ChrisEsau/GDRIVE_Hardware/MotorDriverXL/ComponentReview.ods

Reference | Value | Footprint | MPN | Datasheet
C1 | CAP_2.2uF_25V_0603 | Capacitor_SMD:C_0603_1608Metric | GRM188R61E225KA12D
C10 | CAP_2.2uF_25V_0603 | Capacitor_SMD:C_0603_1608Metric | GRM188R61E225KA12D
C11 | CAP_2.2uF_25V_0603 | Capacitor_SMD:C_0603_1608Metric | GRM188R61E225KA12D
C12 | CAP_2.2uF_25V_0603 | Capacitor_SMD:C_0603_1608Metric | GRM188R61E225KA12D
C13 | CAP_0.022uF_100V_0603 | Capacitor_SMD:C_0603_1608Metric | C0603C223K1RACTU
C14 | CAP_15nF_50V_0603 | Capacitor_SMD:C_0603_1608Metric | CC0603JRX7R9BB153
C15 | CAP_4.7uF_100V_1210 | Capacitor_SMD:C_1210_3225Metric | GCM32DC72A475KE02L
C16 | CAP_2.2uF_25V_0603 | Capacitor_SMD:C_0603_1608Metric | GRM188R61E225KA12D
C17 | CAP_100nF_50V_0603 | Capacitor_SMD:C_0603_1608Metric | CC0603MRY5V9BB104
C18 | CAPP_100uF_6.3V_TANT | Capacitor_SMD:C_1210_3225Metric | 581-TPSB107K006R0400 | https://www.mouser.com/datasheet/2/40/tps-776850.pdf
C19 | CAP_100nF_50V_0603 | Capacitor_SMD:C_0603_1608Metric | CC0603MRY5V9BB104
C2 | CAP_2.2uF_25V_0603 | Capacitor_SMD:C_0603_1608Metric | GRM188R61E225KA12D
C20 | CAP_100nF_50V_0603 | Capacitor_SMD:C_0603_1608Metric | CC0603MRY5V9BB104
C21 | CAP_100nF_50V_0603 | Capacitor_SMD:C_0603_1608Metric | CC0603MRY5V9BB104
C22 | CAP_4.7uF_100V_1210 | Capacitor_SMD:C_1210_3225Metric | GCM32DC72A475KE02L
C23 | CAP_2.2uF_25V_0603 | Capacitor_SMD:C_0603_1608Metric | GRM188R61E225KA12D
C24 | CAPP_100uF_6.3V_TANT | Capacitor_SMD:C_1210_3225Metric | 581-TPSB107K006R0400 | https://www.mouser.com/datasheet/2/40/tps-776850.pdf
C25 | CAP_4.7uF_100V_1210 | Capacitor_SMD:C_1210_3225Metric | GCM32DC72A475KE02L
C26 | CAP_4.7uF_100V_1210 | Capacitor_SMD:C_1210_3225Metric | GCM32DC72A475KE02L
C27 | CAP_4.7uF_100V_1210 | Capacitor_SMD:C_1210_3225Metric | GCM32DC72A475KE02L
C28 | CAP_4.7uF_100V_1210 | Capacitor_SMD:C_1210_3225Metric | GCM32DC72A475KE02L
C29 | CAP_4.7uF_100V_1210 | Capacitor_SMD:C_1210_3225Metric | GCM32DC72A475KE02L
C3 | CAP_2.2uF_25V_0603 | Capacitor_SMD:C_0603_1608Metric | GRM188R61E225KA12D
C30 | CAP_4.7uF_100V_1210 | Capacitor_SMD:C_1210_3225Metric | GCM32DC72A475KE02L
C31 | CAPP_220uF_63V_10X15_THT | Capacitor_THT:CP_Radial_D10.0mm_P5.00mm | ESK227M063AH2AA
C32 | CAP_15pF_16V_0603 | Capacitor_SMD:C_0603_1608Metric | VJ0603A150KXJPW1BC
C33 | CAPP_220uF_63V_10X15_THT | Capacitor_THT:CP_Radial_D10.0mm_P5.00mm | ESK227M063AH2AA
C34 | CAP_15pF_16V_0603 | Capacitor_SMD:C_0603_1608Metric | VJ0603A150KXJPW1BC
C35 | CAP_2.2uF_25V_0603 | Capacitor_SMD:C_0603_1608Metric | GRM188R61E225KA12D
C36 | CAP_100nF_50V_0603 | Capacitor_SMD:C_0603_1608Metric | CC0603MRY5V9BB104
C37 | CAP_2.2uF_25V_0603 | Capacitor_SMD:C_0603_1608Metric | GRM188R61E225KA12D
C38 | CAP_2.2uF_25V_0603 | Capacitor_SMD:C_0603_1608Metric | GRM188R61E225KA12D
C39 | CAP_2.2uF_25V_0603 | Capacitor_SMD:C_0603_1608Metric | GRM188R61E225KA12D
C4 | CAP_2.2uF_25V_0603 | Capacitor_SMD:C_0603_1608Metric | GRM188R61E225KA12D
C40 | CAP_2.2nF_50V_0603 | Capacitor_SMD:C_0603_1608Metric | C0603C222J5RACTU
C41 | CAP_2.2nF_50V_0603 | Capacitor_SMD:C_0603_1608Metric | C0603C222J5RACTU
C42 | CAP_2.2uF_25V_0603 | Capacitor_SMD:C_0603_1608Metric | GRM188R61E225KA12D
C5 | CAP_2.2uF_25V_0603 | Capacitor_SMD:C_0603_1608Metric | GRM188R61E225KA12D
C6 | CAP_2.2uF_25V_0603 | Capacitor_SMD:C_0603_1608Metric | GRM188R61E225KA12D
C7 | CAP_6.8nF_10V_0603 | Capacitor_SMD:C_0603_1608Metric | VJ0603Y682MXQPW1BC
C8 | CAP_120pF_50V_0603 | Capacitor_SMD:C_0603_1608Metric | VJ0603A121JXAAC
C9 | CAP_2.2uF_25V_0603 | Capacitor_SMD:C_0603_1608Metric | GRM188R61E225KA12D
D1 | D_60V_2A_PMEG6020ER | Diode_SMD:D_SOD-123F | PMEG6020ER | https://www.mouser.com/datasheet/2/916/PMEG6020ER-1371207.pdf
D2 | D_TVS_5V | digikey-footprints:DO-214AC |  | https://www.mouser.com/datasheet/2/240/Littelfuse_TVS_Diode_SMAJ_Datasheet.pdf-540740.pdf
D3 | LED_GREEN | LED_SMD:LED_0603_1608Metric | LTST-C191KGKT
D4 | LED_RED | LED_SMD:LED_0603_1608Metric | LTST-C191KRKT
D5 | LED_BLUE | LED_SMD:LED_0603_1608Metric | LTST-C191TBKT
J1 | CONN_USB_B_Micro | digikey-footprints:USB_Micro_B_Female_10118193-0001LF | 10118193-0001LF | https://www.mouser.com/ProductDetail/Amphenol-FCI/10118193-0001LF
L1 | L_2.2uH_600mA_MLZ2012N2R2L | Inductor_SMD:L_0805_2012Metric | MLZ2012N2R2L
L2 | L_22uH_1.5A_SDR0805 | footprints:L_BOURNS_SDR0805 | 652-SDR0805-220ML
P1 | CONN_CAN | Connector_PinHeader_2.54mm:PinHeader_1x04_P2.54mm_Vertical | 90136-1104 | https://www.mouser.com/datasheet/2/276/0901361104_PCB_HEADERS-176953.pdf
P2 | CONN_HALL | Connector_PinHeader_2.54mm:PinHeader_1x05_P2.54mm_Vertical | 90136-1305 | https://www.mouser.com/datasheet/2/276/0901361305_PCB_HEADERS-176832.pdf
P3 | CONN_COMM | Connector_PinHeader_2.54mm:PinHeader_1x08_P2.54mm_Vertical | 90136-1108 | https://www.mouser.com/datasheet/2/276/0901361108_PCB_HEADERS-151719.pdfhttps://www.mouser.com/datasheet/2/276/0901361305_PCB_HEADERS-176832.pdf
P4 | CONN_SWD | Connector_PinHeader_2.54mm:PinHeader_1x05_P2.54mm_Vertical | 90136-1305 | https://www.mouser.com/datasheet/2/276/0901361305_PCB_HEADERS-176832.pdf
P5 | PAD_4x5 | footprints:PAD_4x5
P6 | PAD_4x5 | footprints:PAD_4x5
P7 | PAD_4x5 | footprints:PAD_4x5
P8 | PAD_4x5 | footprints:PAD_4x5
P9 | PAD_4x5 | footprints:PAD_4x5
Q1 | Q_NMOS_60V_70A | footprints:POWERPAK SO-8L SINGLE | SQJA04EP-T1_GE3 | https://www.mouser.com/datasheet/2/427/sqja04ep-1110899.pdfhttps://www.mouser.com/datasheet/2/196/irf7749l2pbf-1302913.pdf
Q2 | Q_NMOS_60V_70A | footprints:POWERPAK SO-8L SINGLE | SQJA04EP-T1_GE3 | https://www.mouser.com/datasheet/2/427/sqja04ep-1110899.pdfhttps://www.mouser.com/datasheet/2/196/irf7749l2pbf-1302913.pdf
Q3 | Q_NMOS_60V_70A | footprints:POWERPAK SO-8L SINGLE | SQJA04EP-T1_GE3 | https://www.mouser.com/datasheet/2/427/sqja04ep-1110899.pdfhttps://www.mouser.com/datasheet/2/196/irf7749l2pbf-1302913.pdf
Q4 | Q_NMOS_60V_70A | footprints:POWERPAK SO-8L SINGLE | SQJA04EP-T1_GE3 | https://www.mouser.com/datasheet/2/427/sqja04ep-1110899.pdfhttps://www.mouser.com/datasheet/2/196/irf7749l2pbf-1302913.pdf
Q5 | Q_NMOS_60V_70A | footprints:POWERPAK SO-8L SINGLE | SQJA04EP-T1_GE3 | https://www.mouser.com/datasheet/2/427/sqja04ep-1110899.pdfhttps://www.mouser.com/datasheet/2/196/irf7749l2pbf-1302913.pdf
Q6 | Q_NMOS_60V_70A | footprints:POWERPAK SO-8L SINGLE | SQJA04EP-T1_GE3 | https://www.mouser.com/datasheet/2/427/sqja04ep-1110899.pdfhttps://www.mouser.com/datasheet/2/196/irf7749l2pbf-1302913.pdf
R1 | RES_2.2K_1%_0603 | Resistor_SMD:R_0603_1608Metric | RC0603JR-072K2L
R10 | RES_10K_1%_0603 | Resistor_SMD:R_0603_1608Metric | RC0603FR-0710KL
R11 | RES_4.7R_1%_0603 | Resistor_SMD:R_0603_1608Metric | RK73H1JTTD4R70F
R12 | RES_4.7R_1%_0603 | Resistor_SMD:R_0603_1608Metric | RK73H1JTTD4R70F
R13 | RES_1m_1%_SHUNT | Resistor_SMD:R_2512_6332Metric | WSLF25121L000FEA | https://www.mouser.com/datasheet/2/427/wslf-974898.pdf
R14 | RES_4.7R_1%_0603 | Resistor_SMD:R_0603_1608Metric | RK73H1JTTD4R70F
R15 | RES_4.7R_1%_0603 | Resistor_SMD:R_0603_1608Metric | RK73H1JTTD4R70F
R16 | RES_1m_1%_SHUNT | Resistor_SMD:R_2512_6332Metric | WSLF25121L000FEA | https://www.mouser.com/datasheet/2/427/wslf-974898.pdf
R17 | RES_4.7R_1%_0603 | Resistor_SMD:R_0603_1608Metric | RK73H1JTTD4R70F
R18 | RES_4.7R_1%_0603 | Resistor_SMD:R_0603_1608Metric | RK73H1JTTD4R70F
R19 | RES_39K_1%_0603 | Resistor_SMD:R_0603_1608Metric | RC0603FR-0739KL
R2 | RES_2.2K_1%_0603 | Resistor_SMD:R_0603_1608Metric | RC0603JR-072K2L
R20 | RES_2.2K_1%_0603 | Resistor_SMD:R_0603_1608Metric | RC0603JR-072K2L
R21 | RES_39K_1%_0603 | Resistor_SMD:R_0603_1608Metric | RC0603FR-0739KL
R22 | RES_2.2K_1%_0603 | Resistor_SMD:R_0603_1608Metric | RC0603JR-072K2L
R23 | RES_39K_1%_0603 | Resistor_SMD:R_0603_1608Metric | RC0603FR-0739KL
R24 | RES_2.2K_1%_0603 | Resistor_SMD:R_0603_1608Metric | RC0603JR-072K2L
R25 | RES_39K_1%_0603 | Resistor_SMD:R_0603_1608Metric | RC0603FR-0739KL
R26 | RES_2.2K_1%_0603 | Resistor_SMD:R_0603_1608Metric | RC0603JR-072K2L
R27 | RES_100R_1%_0603 | Resistor_SMD:R_0603_1608Metric | RC0603FR-07100RL
R28 | RES_100R_1%_0603 | Resistor_SMD:R_0603_1608Metric | RC0603FR-07100RL
R29 | RES_2.2K_1%_0603 | Resistor_SMD:R_0603_1608Metric | RC0603JR-072K2L
R3 | RES_2.2K_1%_0603 | Resistor_SMD:R_0603_1608Metric | RC0603JR-072K2L
R30 | RES_100R_1%_0603 | Resistor_SMD:R_0603_1608Metric | RC0603FR-07100RL
R31 | RES_100R_1%_0603 | Resistor_SMD:R_0603_1608Metric | RC0603FR-07100RL
R32 | RES_100R_1%_0603 | Resistor_SMD:R_0603_1608Metric | RC0603FR-07100RL
R33 | RES_100R_1%_0603 | Resistor_SMD:R_0603_1608Metric | RC0603FR-07100RL
R34 | RES_10K_1%_0603 | Resistor_SMD:R_0603_1608Metric | RC0603FR-0710KL
R4 | RES_22R_1%_0603 | Resistor_SMD:R_0603_1608Metric | RC0603FR-0722RL
R5 | RES_22R_1%_0603 | Resistor_SMD:R_0603_1608Metric | RC0603FR-0722RL
R6 | RES_3.3K_1%_0603 | Resistor_SMD:R_0603_1608Metric | RC0603FR-073K3L
R7 | RES_18K_1%_0603 | Resistor_SMD:R_0603_1608Metric | RC0603FR-0718KL
R8 | RES_15K_1%_0603 | Resistor_SMD:R_0603_1608Metric | RC0603FR-0715KL
R9 | RES_220K_1%_0603 | Resistor_SMD:R_0603_1608Metric | RC0603FR-07220KL
TH1 | TH_NTC_10K_1%_0603 | Resistor_SMD:R_0603_1608Metric | NCP18XH103F03RB
U1 | IC_TJA1051T3 | Package_SO:SO-8_5.3x6.2mm_P1.27mm | TJA1051T/3,118 | https://www.mouser.com/datasheet/2/302/TJA1051-1127850.pdf
U2 | IC_STM32F405RGT6 | Package_QFP:LQFP-64_10x10mm_P0.5mm | STM32F405RGT6 | https://www.mouser.com/datasheet/2/389/stm32f405rg-956214.pdf
U3 | IC_LM3671MF | Package_TO_SOT_SMD:TSOT-23-5 | LM3671MF-1.8/NOPB
U4 | IC_DRV8301 | Package_SO:HTSSOP-56-1EP_6.1x14mm_P0.5mm_EP3.61x6.35mm | DRV8301DCAR | http://www.ti.com/lit/ds/symlink/drv8301.pdf
X1 | XTAL_8Mhz_ABM3B | Crystal:Crystal_SMD_Abracon_ABM3B-4Pin_5.0x3.2mm | 815-ABM3B-8.0-10-1UT
Board Area | 7.1412
