ChrisEsau/GDRIVE_Hardware/MotorDriverXL/3D_Models/sdr0805-220ml.stp

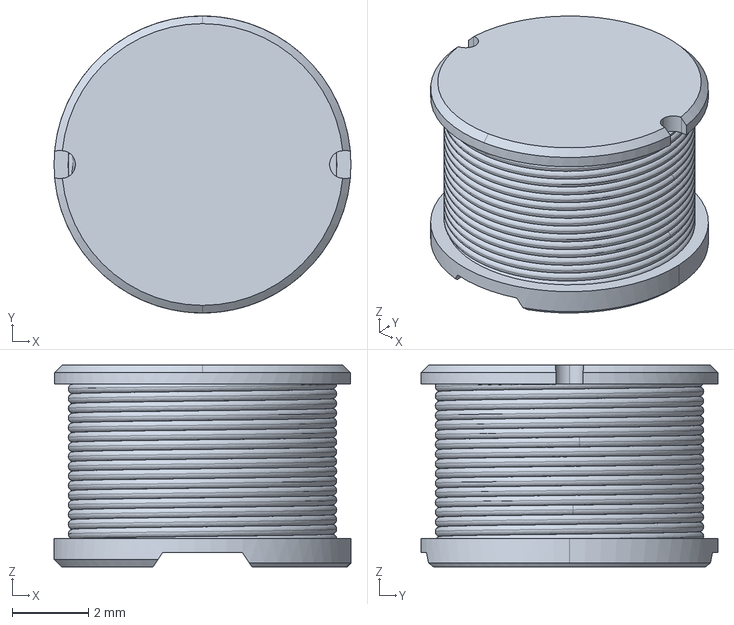
[picture p1: CAD file, 2019-03-09]
MotorDriverXL/3D_Models/sdr0805-220ml.stp
7.80 x 7.80 x 5.30 mm
