ChrisEsau/GDRIVE_Hardware/MotorDriverXL/3D_Models/10118193-0001lfc.stp

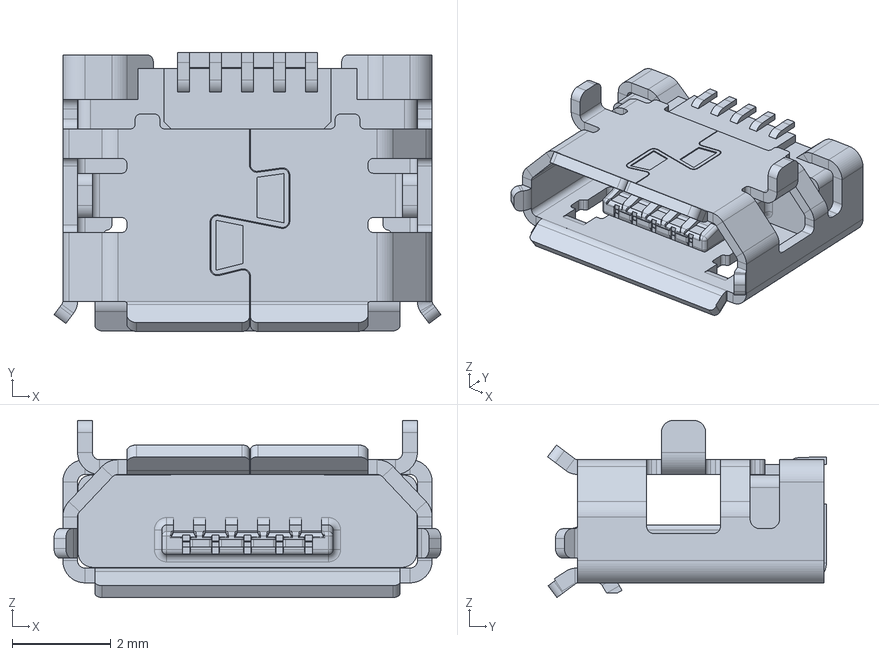
[picture p2: CAD file, 2019-03-09]
MotorDriverXL/3D_Models/10118193-0001lfc.stp
7.86 x 5.66 x 3.60 mm
