ChrisEsau/GDRIVE_Hardware/MotorDriverXL/3D_Models/901361104.stp

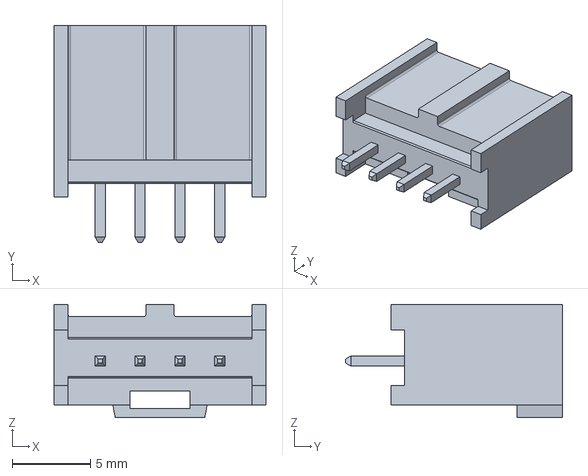
[picture p3: CAD file, 2019-03-09]
MotorDriverXL/3D_Models/901361104.stp
13.5 x 13.8 x 7.21 mm
