ChrisEsau/GDRIVE_Hardware/(list of files, cad)

Other CAD files:
MotorDriverXL/3D_Models/10118193-0001lf.stp
