ChrisEsau/GDRIVE_Hardware/MotorDriverXL/MotorDriverXL.kicad_pcb

## KiCad design MotorDriverXL/MotorDriverXL.kicad_pcb (2019-03-09)

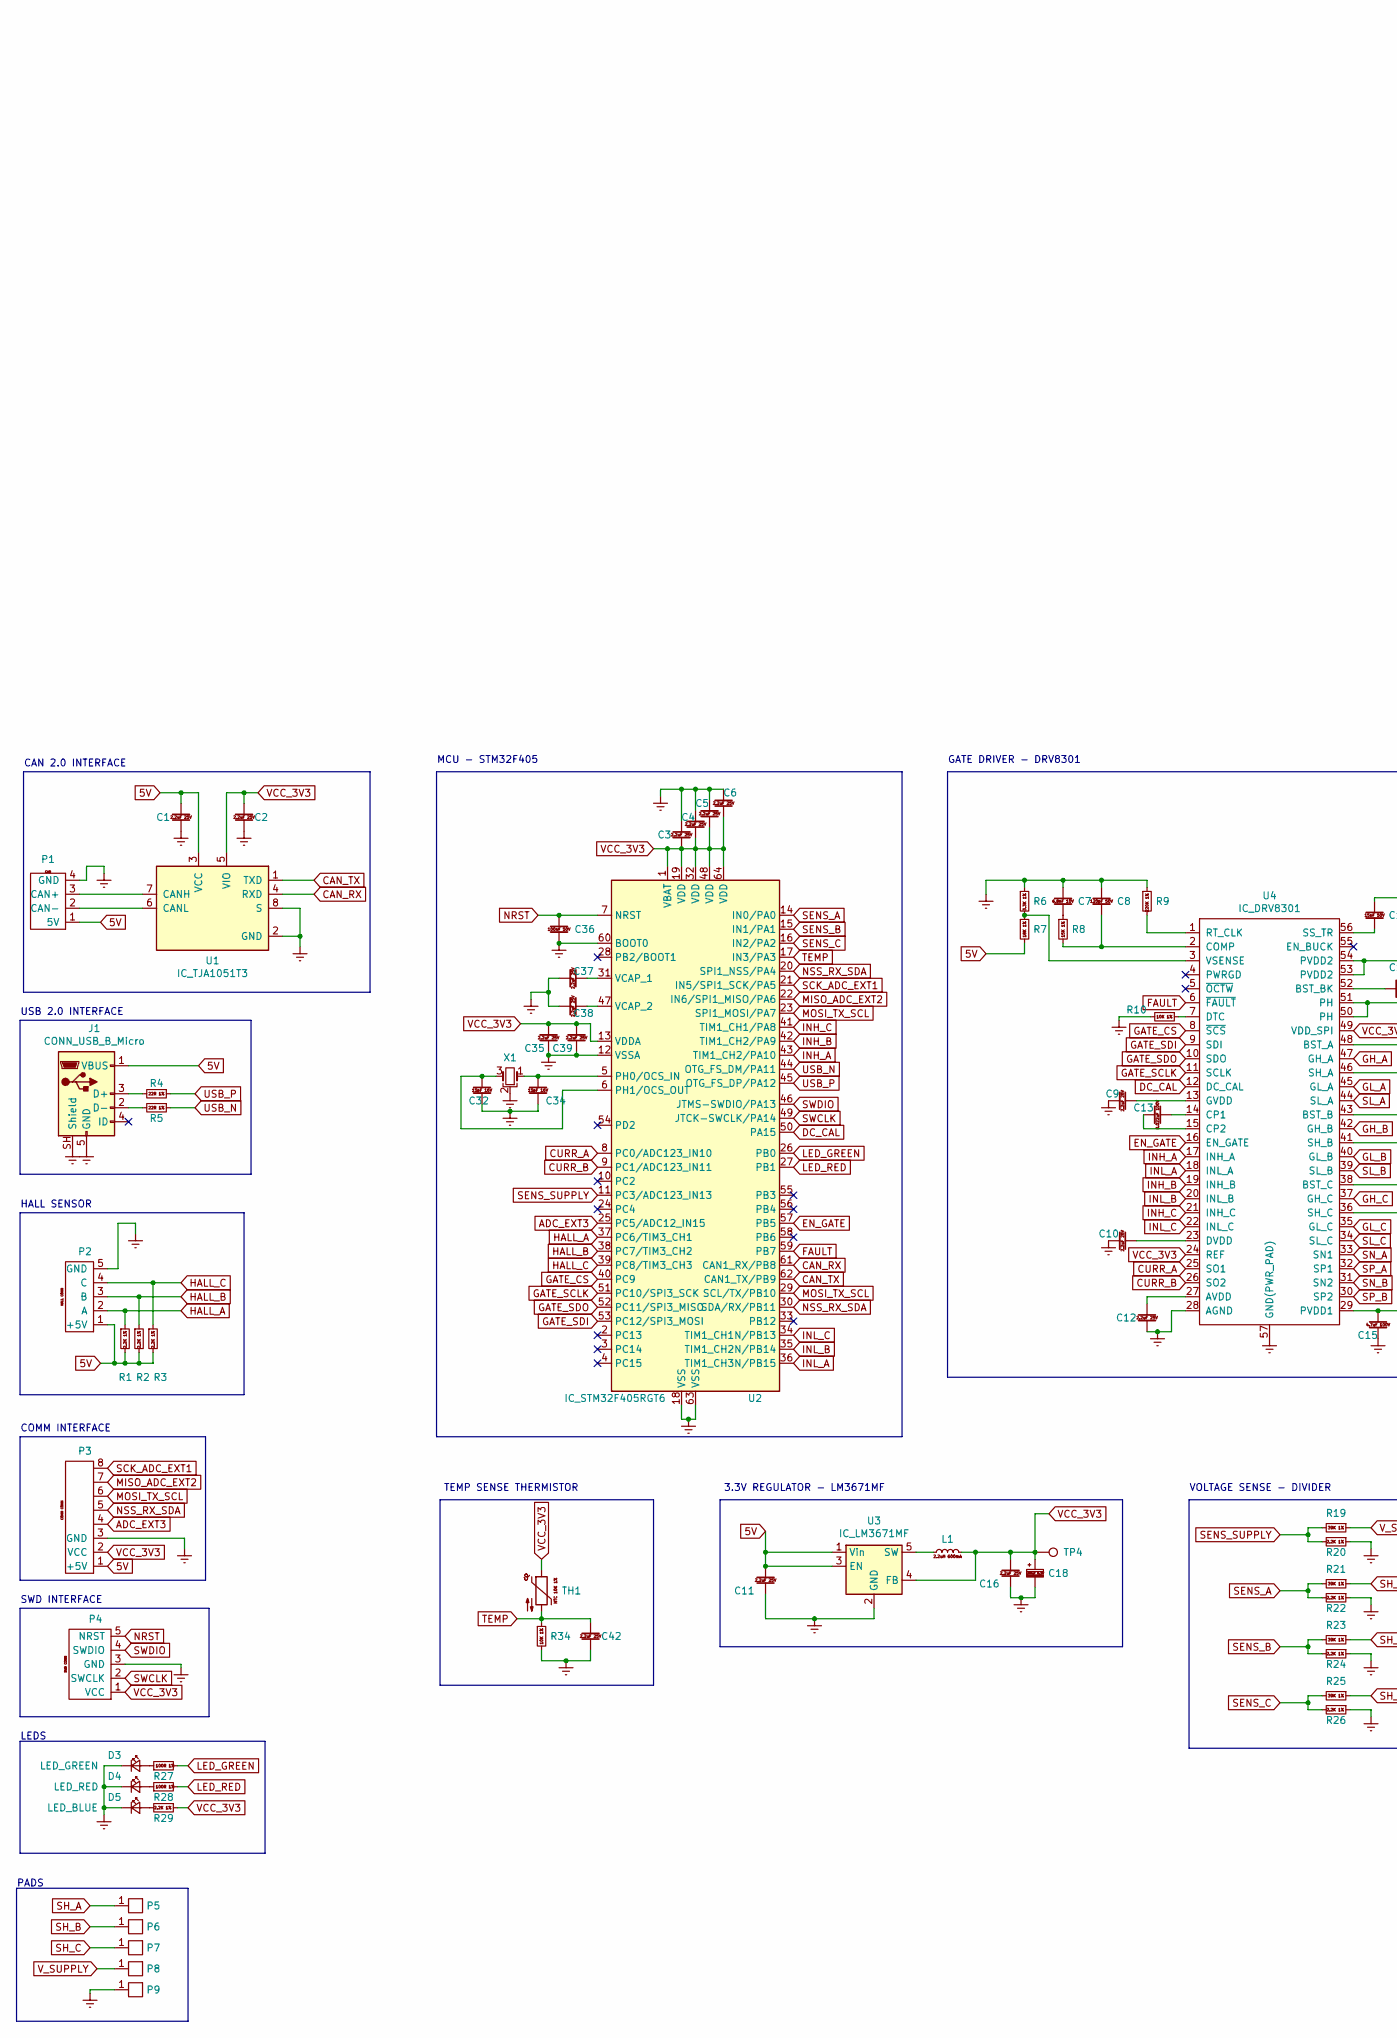
[picture p4: schematic MotorDriverXL.sch, part in row 1, column 1]

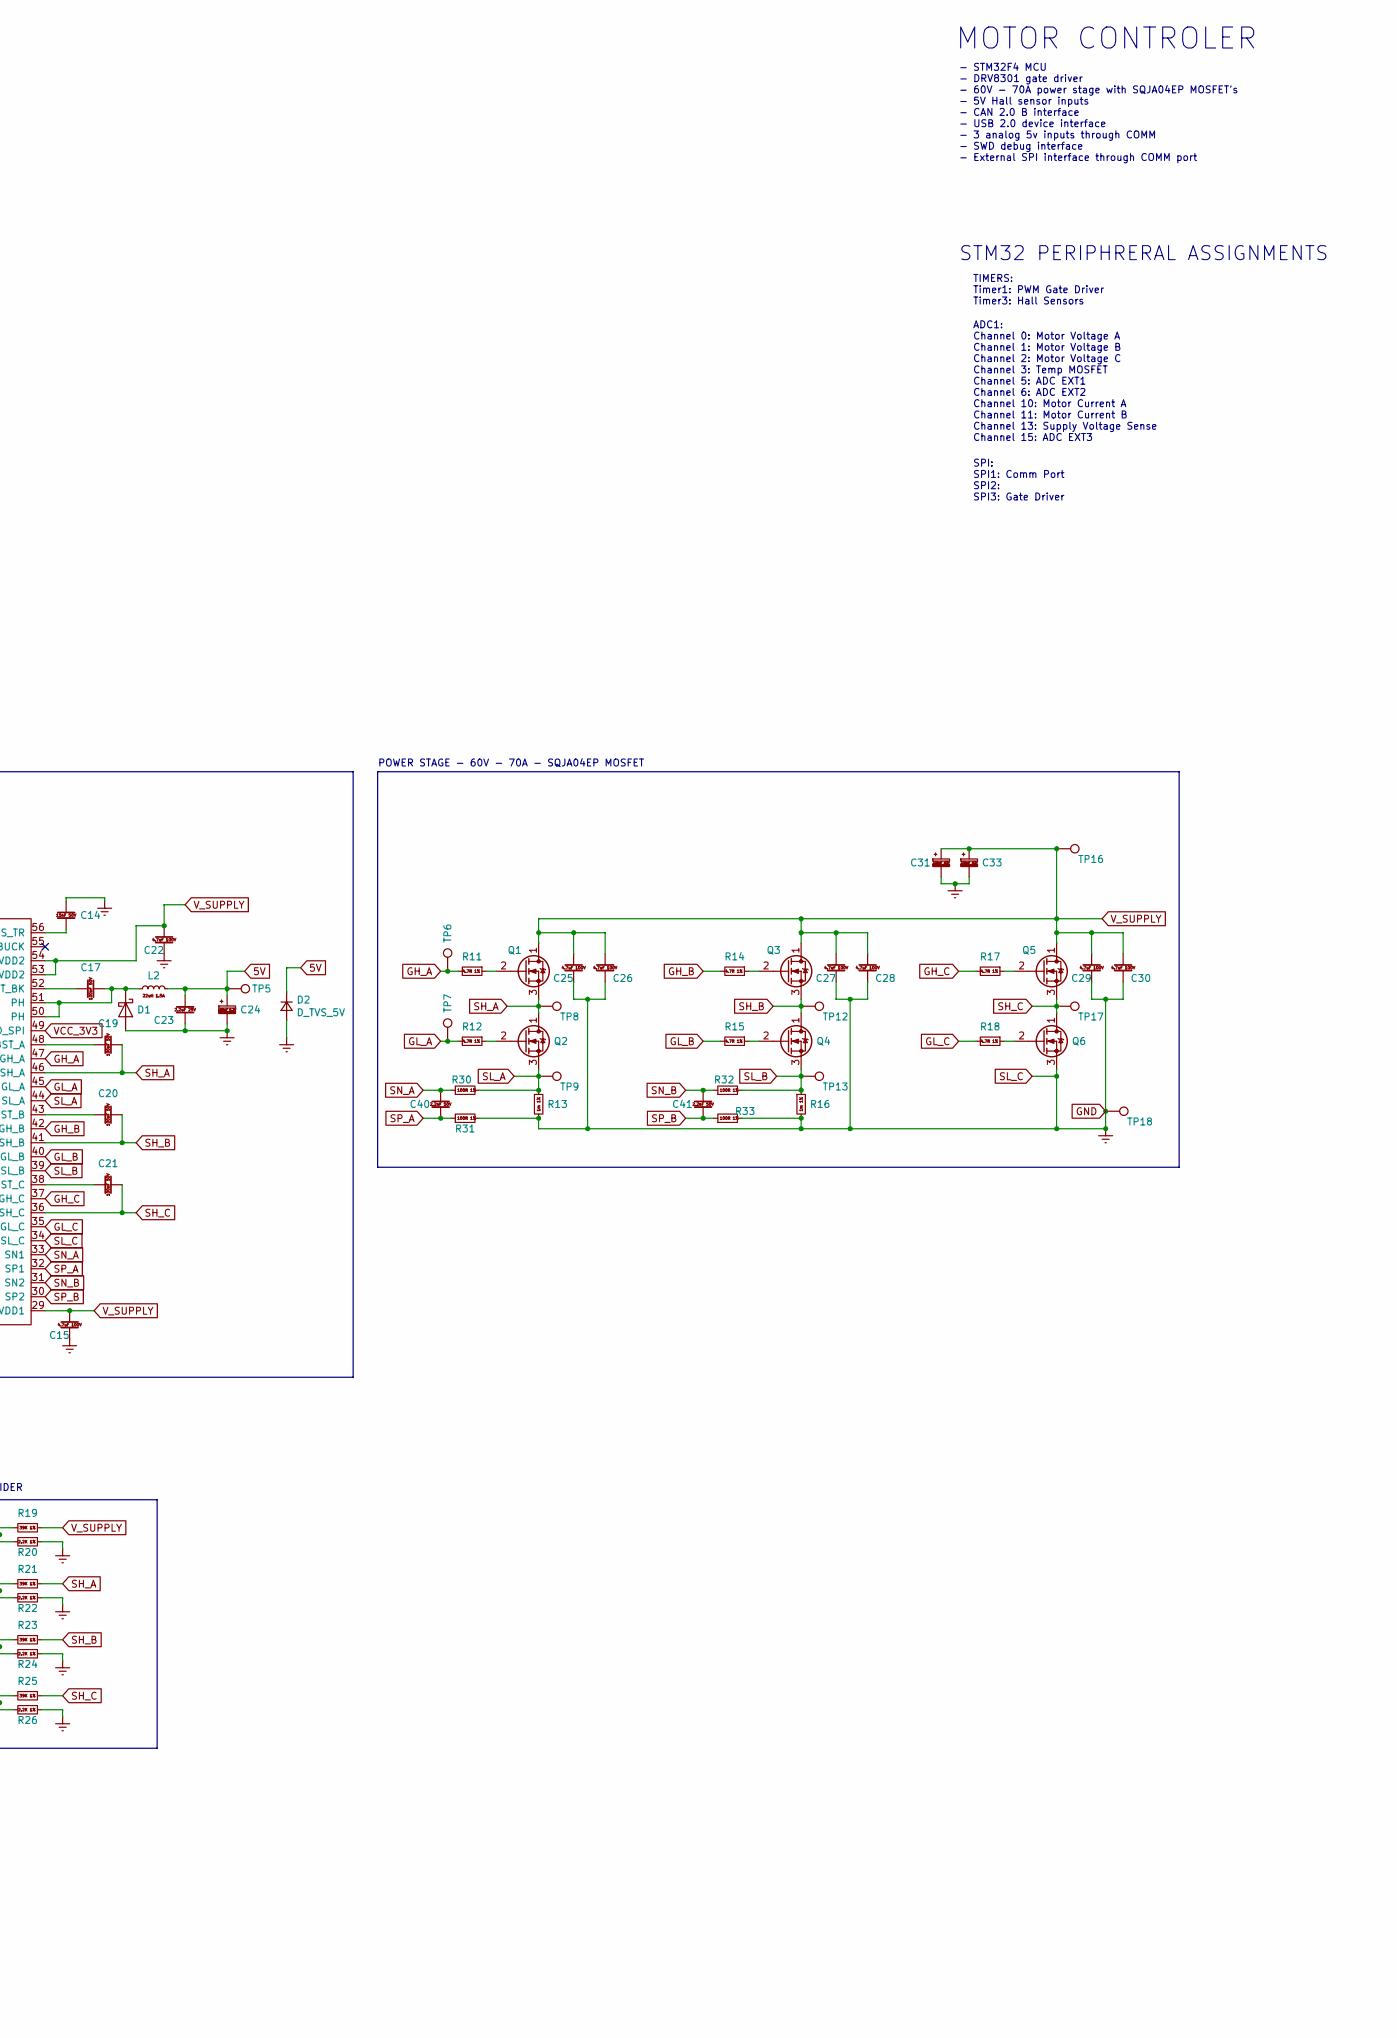
[picture p5: schematic MotorDriverXL.sch, part in row 1, column 2]

Parts:
C1, C2, C3, C4, C5, C6, C9, C10, C11, C12, C16, C23, C35, C37, C38, C39, C42: CAP_2.2uF_25V_0603; C_0603_1608Metric; MPN GRM188R61E225KA12D
C7: CAP_6.8nF_10V_0603; C_0603_1608Metric; MPN VJ0603Y682MXQPW1BC
C8: CAP_120pF_50V_0603; C_0603_1608Metric; MPN VJ0603A121JXAAC
C13: CAP_0.022uF_100V_0603; C_0603_1608Metric; MPN C0603C223K1RACTU
C14: CAP_15nF_50V_0603; C_0603_1608Metric; MPN CC0603JRX7R9BB153
C15, C22, C25, C26, C27, C28, C29, C30: CAP_4.7uF_100V_1210; C_1210_3225Metric; MPN GCM32DC72A475KE02L
C17, C19, C20, C21, C36: CAP_100nF_50V_0603; C_0603_1608Metric; MPN CC0603MRY5V9BB104
C18, C24: CAPP_100uF_6.3V_TANT; C_1210_3225Metric; MPN 581-TPSB107K006R0400
C31, C33: CAPP_220uF_63V_10X15_THT; CP_Radial_D10.0mm_P5.00mm; MPN ESK227M063AH2AA
C32, C34: CAP_15pF_16V_0603; C_0603_1608Metric; MPN VJ0603A150KXJPW1BC
C40, C41: CAP_2.2nF_50V_0603; C_0603_1608Metric; MPN C0603C222J5RACTU
D1: D_60V_2A_PMEG6020ER; D_SOD-123F; MPN PMEG6020ER
D2: D_TVS_5V; DO-214AC
D3: LED_GREEN; LED_0603_1608Metric; MPN LTST-C191KGKT
D4: LED_RED; LED_0603_1608Metric; MPN LTST-C191KRKT
D5: LED_BLUE; LED_0603_1608Metric; MPN LTST-C191TBKT
J1: CONN_USB_B_Micro; USB_Micro_B_Female_10118193-0001LF; MPN 10118193-0001LF
L1: L_2.2uH_600mA_MLZ2012N2R2L; L_0805_2012Metric; MPN MLZ2012N2R2L
L2: L_22uH_1.5A_SDR0805; L_BOURNS_SDR0805; MPN 652-SDR0805-220ML
P1: CONN_CAN; PinHeader_1x04_P2.54mm_Vertical; MPN 90136-1104
P2: CONN_HALL; PinHeader_1x05_P2.54mm_Vertical; MPN 90136-1305
P3: CONN_COMM; PinHeader_1x08_P2.54mm_Vertical; MPN 90136-1108
P4: CONN_SWD; PinHeader_1x05_P2.54mm_Vertical; MPN 90136-1305
P5, P6, P7, P8, P9: PAD_4x5
Q1, Q2, Q3, Q4, Q5, Q6: Q_NMOS_60V_70A; POWERPAK SO-8L SINGLE; MPN SQJA04EP-T1_GE3
R1, R2, R3, R20, R22, R24, R26, R29: RES_2.2K_1%_0603; R_0603_1608Metric; MPN RC0603JR-072K2L
R4, R5: RES_22R_1%_0603; R_0603_1608Metric; MPN RC0603FR-0722RL
R6: RES_3.3K_1%_0603; R_0603_1608Metric; MPN RC0603FR-073K3L
R7: RES_18K_1%_0603; R_0603_1608Metric; MPN RC0603FR-0718KL
R8: RES_15K_1%_0603; R_0603_1608Metric; MPN RC0603FR-0715KL
R9: RES_220K_1%_0603; R_0603_1608Metric; MPN RC0603FR-07220KL
R10, R34: RES_10K_1%_0603; R_0603_1608Metric; MPN RC0603FR-0710KL
R11, R12, R14, R15, R17, R18: RES_4.7R_1%_0603; R_0603_1608Metric; MPN RK73H1JTTD4R70F
R13, R16: RES_1m_1%_SHUNT; R_2512_6332Metric; MPN WSLF25121L000FEA
R19, R21, R23, R25: RES_39K_1%_0603; R_0603_1608Metric; MPN RC0603FR-0739KL
R27, R28, R30, R31, R32, R33: RES_100R_1%_0603; R_0603_1608Metric; MPN RC0603FR-07100RL
TH1: TH_NTC_10K_1%_0603; R_0603_1608Metric; MPN NCP18XH103F03RB
TP4, TP5, TP6, TP7, TP8, TP9, TP12, TP13, TP16, TP17, TP18: TestPoint; TestPoint_Pad_2.0x2.0mm
U1: IC_TJA1051T3; SO-8_5.3x6.2mm_P1.27mm; MPN TJA1051T/3,118
U2: IC_STM32F405RGT6; LQFP-64_10x10mm_P0.5mm; MPN STM32F405RGT6
U3: IC_LM3671MF; TSOT-23-5; MPN LM3671MF-1.8/NOPB
U4: IC_DRV8301; HTSSOP-56-1EP_6.1x14mm_P0.5mm_EP3.61x6.35mm; MPN DRV8301DCAR
X1: XTAL_8Mhz_ABM3B; Crystal_SMD_Abracon_ABM3B-4Pin_5.0x3.2mm; MPN 815-ABM3B-8.0-10-1UT

Connections:
5V: C1.2, C11.2, C23.2, C24.1, D2.K, J1.1 (VBUS), L2.2, P1.1 (5V), P2.1 (+5V), P3.1 (+5V), R1.2, R2.2, R3.2, R7.2, TP5.1, U1.3 (VCC), U3.1 (Vin), U3.3 (EN)
ADC_EXT3: P3.4, U2.25 (PC5/ADC12_IN15)
CAN_RX: U1.4 (RXD), U2.61 (CAN1_RX/PB8)
CAN_TX: U1.1 (TXD), U2.62 (CAN1_TX/PB9)
CURR_A: U2.8 (PC0/ADC123_IN10), U4.25 (SO1)
CURR_B: U2.9 (PC1/ADC123_IN11), U4.26 (SO2)
DC_CAL: U2.50 (PA15), U4.12 (DC_CAL)
EN_GATE: U2.57 (PB5), U4.16 (EN_GATE)
FAULT: U2.59 (PB7), U4.6 (~FAULT)
GATE_CS: U2.40 (PC9), U4.8 (~SCS)
GATE_SCLK: U2.51 (PC10/SPI3_SCK), U4.11 (SCLK)
GATE_SDI: U2.53 (PC12/SPI3_MOSI), U4.9 (SDI)
GATE_SDO: U2.52 (PC11/SPI3_MISO), U4.10 (SDO)
GH_A: R11.2, TP6.1, U4.47 (GH_A)
GH_B: R14.2, U4.42 (GH_B)
GH_C: R17.2, U4.37 (GH_C)
GL_A: R12.2, TP7.1, U4.45 (GL_A)
GL_B: R15.2, U4.40 (GL_B)
GL_C: R18.2, U4.35 (GL_C)
GND: C1.1, C2.1, C3.1, C4.2, C5.2, C6.2, C7.1, C8.1, C9.2, C10.2, C11.1, C12.2, C14.1, C15.2, C16.1, C18.2, C22.2, C23.1, C24.2, C25.2, C26.2, C27.2, C28.2, C29.2, C30.2, C31.2, C32.2, C33.2, C34.2, C35.1, C36.2, C37.2, C38.2, C39.1, C42.1, D1.2 (A), D2.A, D3.1 (K), D4.1 (K), D5.1 (K), J1.5 (GND), J1.SH (Shield), P1.4 (GND), P2.5 (GND), P3.3 (GND), P4.3 (GND), P9.1, Q6.3 (S), R6.1, R9.1, R10.2, R13.2, R16.2, R20.1, R22.1, R24.1, R26.1, R31.2, R33.2, R34.2, TP18.1, U1.2 (GND), U1.8 (S), U2.12 (VSSA), U2.18 (VSS), U2.60 (BOOT0), U2.63 (VSS), U3.2 (GND), U4.28 (AGND), U4.34 (SL_C), U4.57 (GND(PWR_PAD)), X1.2
HALL_A: P2.2 (A), R1.1, U2.37 (PC6/TIM3_CH1)
HALL_B: P2.3 (B), R2.1, U2.38 (PC7/TIM3_CH2)
HALL_C: P2.4 (C), R3.1, U2.39 (PC8/TIM3_CH3)
INH_A: U2.43 (TIM1_CH2/PA10), U4.17 (INH_A)
INH_B: U2.42 (TIM1_CH2/PA9), U4.19 (INH_B)
INH_C: U2.41 (TIM1_CH1/PA8), U4.21 (INH_C)
INL_A: U2.36 (TIM1_CH3N/PB15), U4.18 (INL_A)
INL_B: U2.35 (TIM1_CH2N/PB14), U4.20 (INL_B)
INL_C: U2.34 (TIM1_CH1N/PB13), U4.22 (INL_C)
LED_GREEN: R27.2, U2.26 (PB0)
LED_RED: R28.2, U2.27 (PB1)
MISO_ADC_EXT2: P3.7, U2.22 (IN6/SPI1_MISO/PA6)
MOSI_TX_SCL: P3.6, U2.23 (SPI1_MOSI/PA7), U2.29 (SCL/TX/PB10)
NRST: C36.1, P4.5 (NRST), U2.7 (NRST)
NSS_RX_SDA: P3.5, U2.20 (SPI1_NSS/PA4), U2.30 (SDA/RX/PB11)
unnamed: C7.2, R8.1
unnamed: C8.2, R8.2, U4.2 (COMP)
unnamed: C9.1, U4.13 (GVDD)
unnamed: C10.1, U4.23 (DVDD)
unnamed: C12.1, U4.27 (AVDD)
unnamed: C13.1, U4.14 (CP1)
unnamed: C13.2, U4.15 (CP2)
unnamed: C14.2, U4.56 (SS_TR)
unnamed: C17.1, D1.1 (K), L2.1, U4.50 (PH), U4.51 (PH)
unnamed: C17.2, U4.52 (BST_BK)
unnamed: C19.2, U4.48 (BST_A)
unnamed: C20.2, U4.43 (BST_B)
unnamed: C21.2, U4.38 (BST_C)
unnamed: C32.1, U2.6 (PH1/OCS_OUT), X1.3
unnamed: C34.1, U2.5 (PH0/OCS_IN), X1.1
unnamed: C37.1, U2.31 (VCAP_1)
unnamed: C38.1, U2.47 (VCAP_2)
unnamed: D3.2 (A), R27.1
unnamed: D4.2 (A), R28.1
unnamed: D5.2 (A), R29.2
unnamed: J1.2 (D-), R5.2
unnamed: J1.3 (D+), R4.2
unnamed: L1.1, U3.5 (SW)
unnamed: P1.2 (CAN-), U1.6 (CANL)
unnamed: P1.3 (CAN+), U1.7 (CANH)
unnamed: Q1.2 (G), R11.1
unnamed: Q2.2 (G), R12.1
unnamed: Q3.2 (G), R14.1
unnamed: Q4.2 (G), R15.1
unnamed: Q5.2 (G), R17.1
unnamed: Q6.2 (G), R18.1
unnamed: R6.2, R7.1, U4.3 (VSENSE)
unnamed: R9.2, U4.1 (RT_CLK)
unnamed: R10.1, U4.7 (DTC)
SCK_ADC_EXT1: P3.8, U2.21 (IN5/SPI1_SCK/PA5)
SENS_A: R21.2, R22.2, U2.14 (IN0/PA0)
SENS_B: R23.2, R24.2, U2.15 (IN1/PA1)
SENS_C: R25.2, R26.2, U2.16 (IN2/PA2)
SENS_SUPPLY: R19.2, R20.2, U2.11 (PC3/ADC123_IN13)
SH_A: C19.1, P5.1, Q1.3 (S), Q2.1 (D), R21.1, TP8.1, U4.46 (SH_A)
SH_B: C20.1, P6.1, Q3.3 (S), Q4.1 (D), R23.1, TP12.1, U4.41 (SH_B)
SH_C: C21.1, P7.1, Q5.3 (S), Q6.1 (D), R25.1, TP17.1, U4.36 (SH_C)
SL_A: Q2.3 (S), R13.1, R30.2, TP9.1, U4.44 (SL_A)
SL_B: Q4.3 (S), R16.1, R32.2, TP13.1, U4.39 (SL_B)
SN_A: C40.1, R30.1, U4.33 (SN1)
SN_B: C41.1, R32.1, U4.31 (SN2)
SP_A: C40.2, R31.1, U4.32 (SP1)
SP_B: C41.2, R33.1, U4.30 (SP2)
SWCLK: P4.2 (SWCLK), U2.49 (JTCK-SWCLK/PA14)
SWDIO: P4.4 (SWDIO), U2.46 (JTMS-SWDIO/PA13)
TEMP: C42.2, R34.1, TH1.2, U2.17 (IN3/PA3)
USB_N: R5.1, U2.44 (OTG_FS_DM/PA11)
USB_P: R4.1, U2.45 (OTG_FS_DP/PA12)
VCC_3V3: C2.2, C3.2, C4.1, C5.1, C6.1, C16.2, C18.1, C35.2, C39.2, L1.2, P3.2 (VCC), P4.1 (VCC), R29.1, TH1.1, TP4.1, U1.5 (VIO), U2.1 (VBAT), U2.13 (VDDA), U2.19 (VDD), U2.32 (VDD), U2.48 (VDD), U2.64 (VDD), U3.4 (FB), U4.24 (REF), U4.49 (VDD_SPI)
V_SUPPLY: C15.1, C22.1, C25.1, C26.1, C27.1, C28.1, C29.1, C30.1, C31.1, C33.1, P8.1, Q1.1 (D), Q3.1 (D), Q5.1 (D), R19.1, TP16.1, U4.29 (PVDD1), U4.53 (PVDD2), U4.54 (PVDD2)

Notes on the sheet:
TIMERS: Timer1: PWM Gate Driver Timer3: Hall Sensors
ADC1: Channel 0: Motor Voltage A Channel 1: Motor Voltage B Channel 2: Motor Voltage C Channel 3: Temp MOSFET Channel 5: ADC EXT1 Channel 6: ADC EXT2 Channel 10: Motor Current A Channel 11: Motor Current B Channel 13: Supply Voltage Sense Channel 15: ADC EXT3
SPI: SPI1: Comm Port SPI2: SPI3: Gate Driver
PADS
LEDS
SWD INTERFACE
COMM INTERFACE
HALL SENSOR
USB 2.0 INTERFACE
CAN 2.0 INTERFACE
MCU - STM32F405
GATE DRIVER - DRV8301
3.3V REGULATOR - LM3671MF
POWER STAGE - 60V - 70A - SQJA04EP MOSFET
TEMP SENSE THERMISTOR
VOLTAGE SENSE - DIVIDER
MOTOR CONTROLER
- STM32F4 MCU - DRV8301 gate driver - 60V - 70A power stage with SQJA04EP MOSFET's - 5V Hall sensor inputs - CAN 2.0 B interface - USB 2.0 device interface - 3 analog 5v inputs through COMM - SWD debug interface - External SPI interface through COMM port
STM32 PERIPHRERAL ASSIGNMENTS

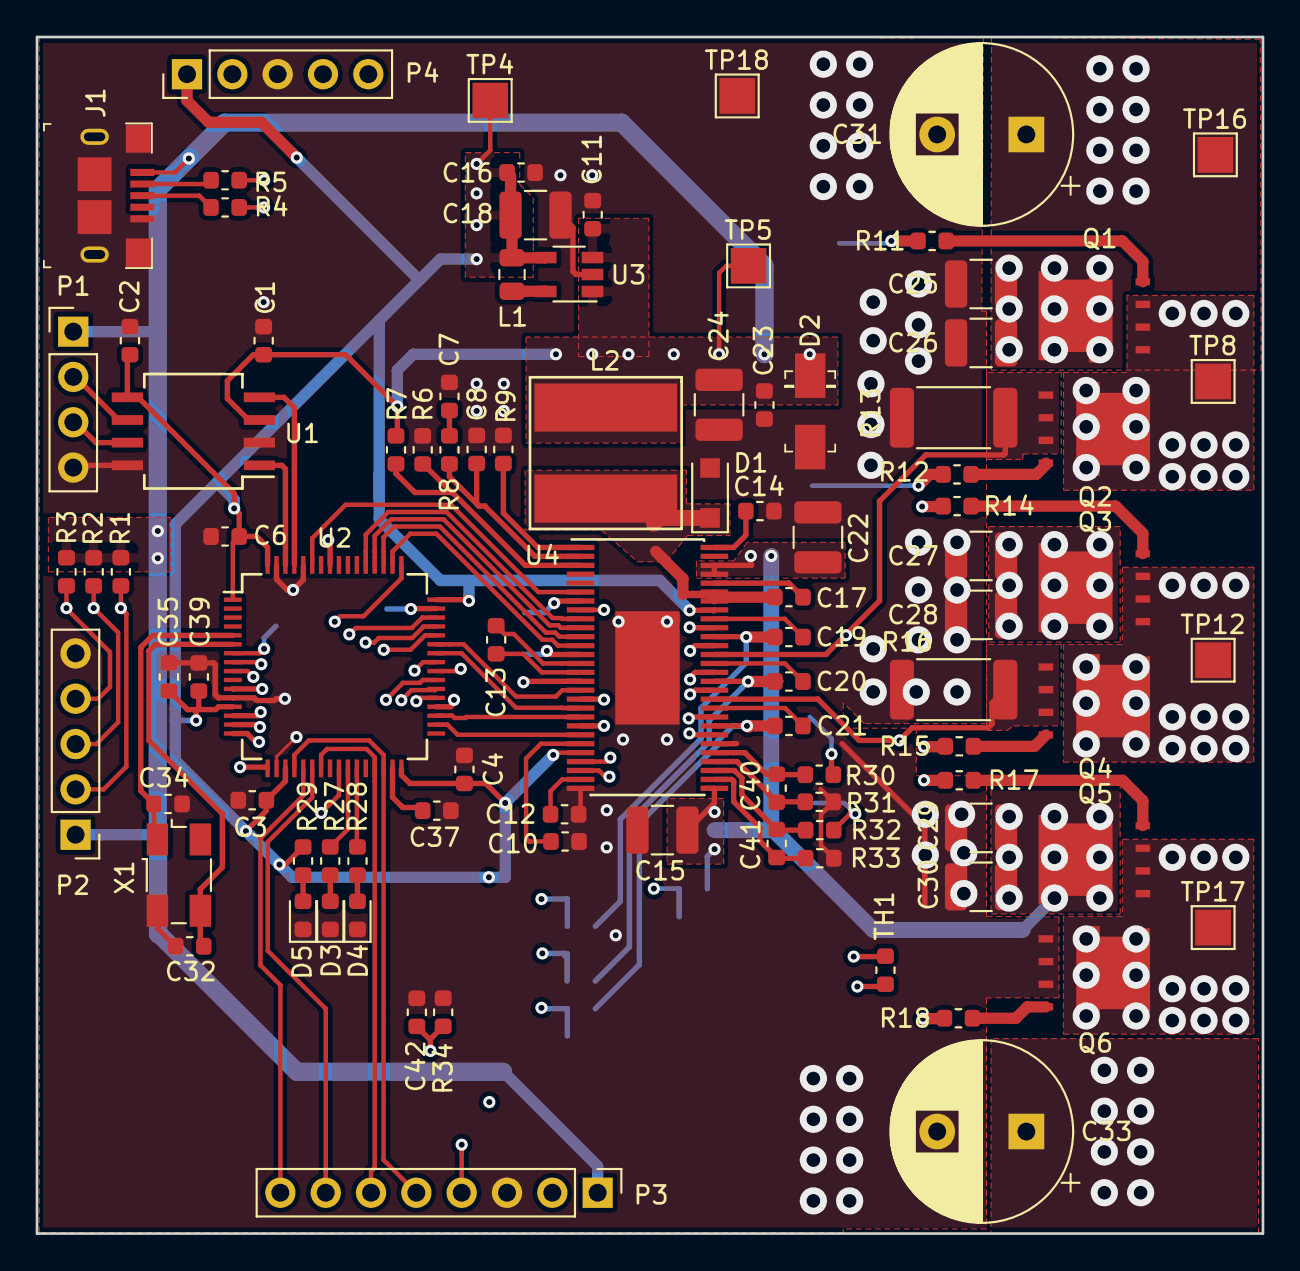
[picture p6: board MotorDriverXL.kicad_pcb from above]

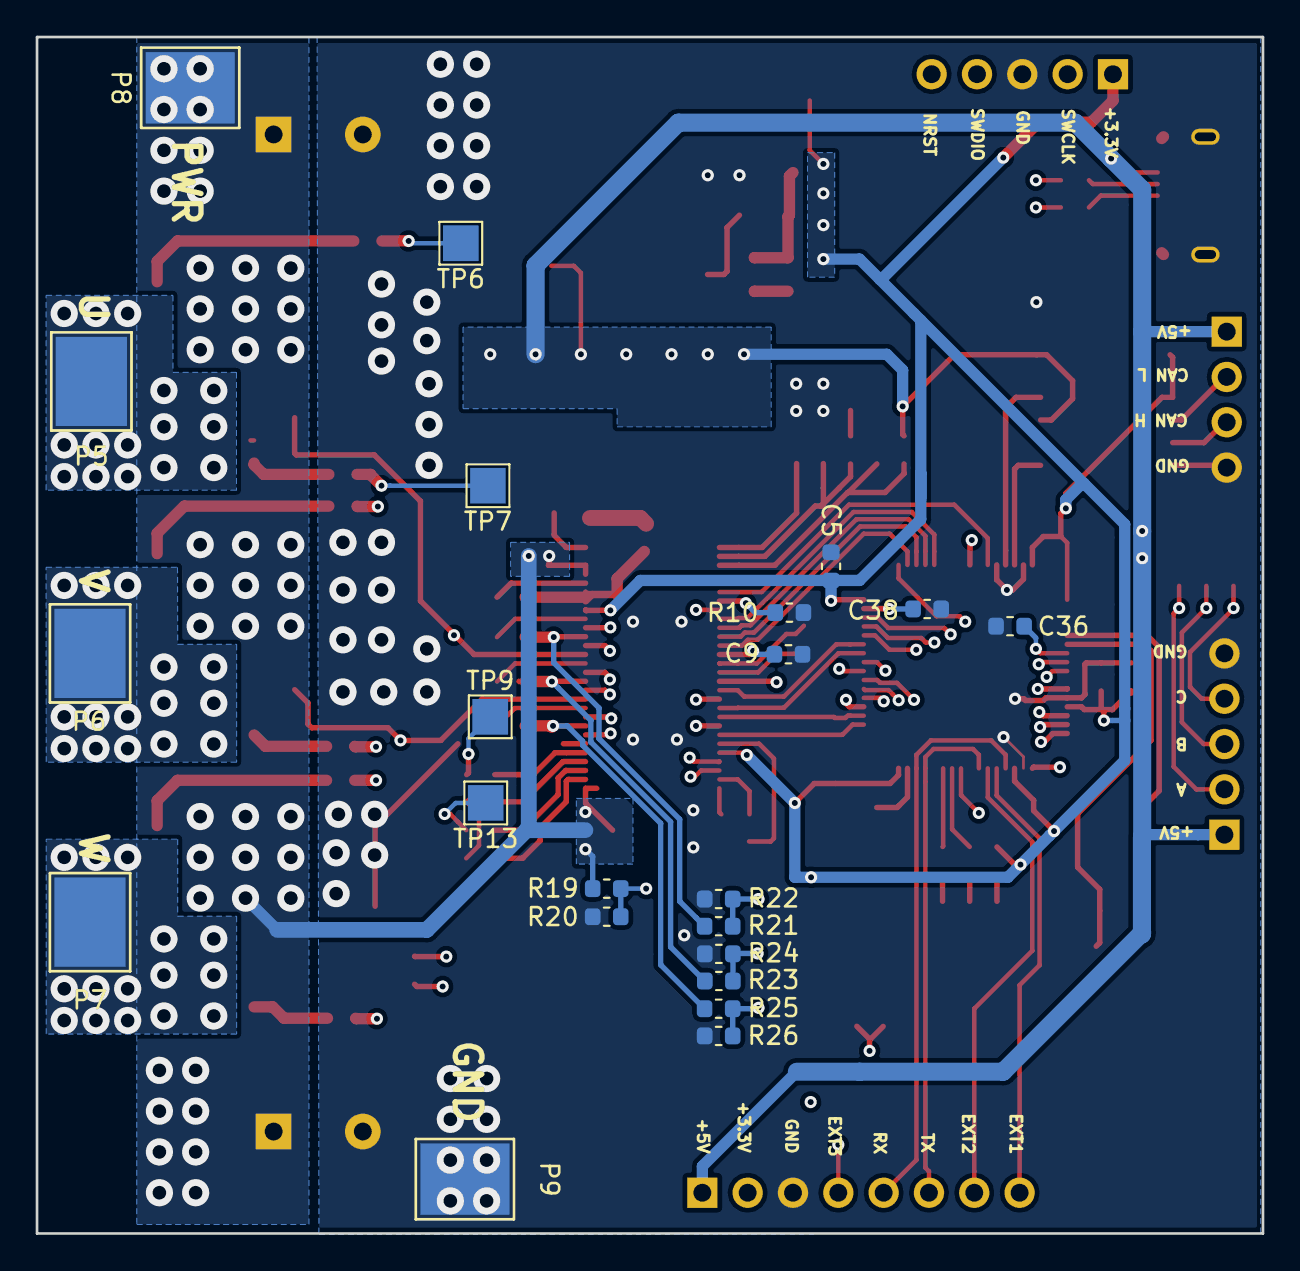
[picture p7: board MotorDriverXL.kicad_pcb from below]

Board: 4 copper layers, 68.7 x 67.1 mm, 116 parts (22 on the bottom side), 90 nets.
